JaimeNF/uno-q-robot/(notices)

Notices in the files:
README.md:
License: MIT
